4T-tech/4T_L01/README.md

4T_L01

单片机应用技术开发板硬件资料

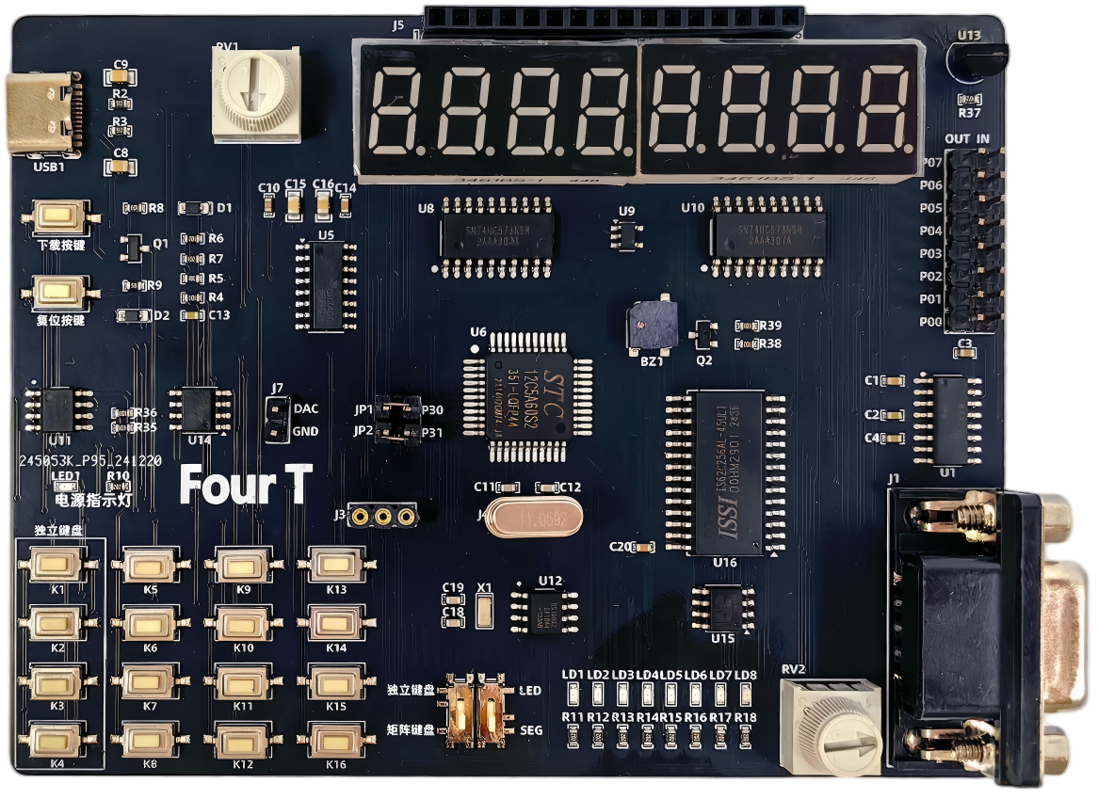
[picture p1: [4]图片/单片机原理及接口技术开发板.png]


## 文件结构
- [1]硬件平台资料：各类文档以及数据手册
  - 单片机原理及接口技术开发板用户手册
  - 数据手册：相关数据手册内容

- [2]综合测试例程：综合测试程序
  - 综合测试程序
  - 测试程序介绍文件
  
- [3]原理图：原理图

- [4]图片：图片资源

- LICENSE：许可证

## 订购渠道

① 官方淘宝：[gxct.taobao.com]()

② 四梯商城：https://www.4t.wiki/mall

③ 官方京东：https://mall.jd.com/index-16359606.html

## 学习资源获取

- QQ交流群：824313199
- 微信公众号：微信搜索“四梯”
- 四梯评测网获取更多竞赛资讯：https://4t.wiki/
  - 交流社区：https://www.4t.wiki/community
  - 学习资源：https://www.4t.wiki/curriculum
- Bilibili平台：参赛选手经验分享、试题解析，B站搜索“四梯科技”
  
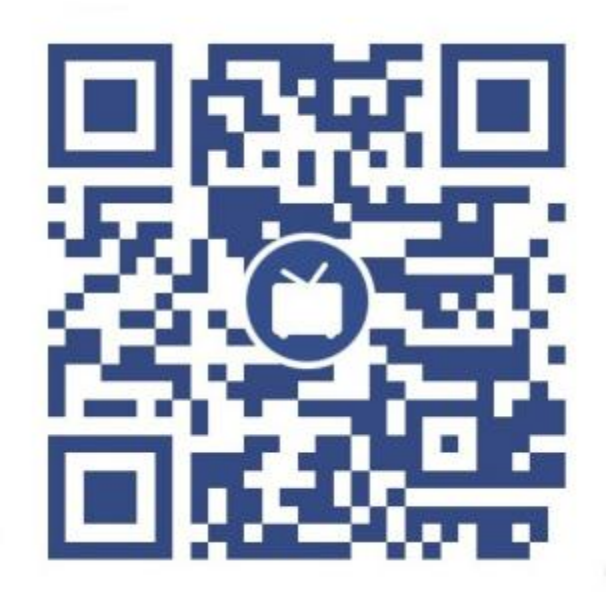
[picture p2: [4]图片/4T_B站.png]
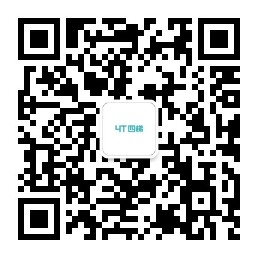
[picture p3: [4]图片/4T_公众号.png]
