4T-tech/4T_L01/(list of files, cad)

Other CAD files:
[2]综合测试例程/综合测试程序/Objects/main.obj
[2]综合测试例程/综合测试程序/Objects/STARTUP.obj
[2]综合测试例程/综合测试程序/Objects/LCD1602.obj
[2]综合测试例程/综合测试程序/Objects/Uart.obj
[2]综合测试例程/综合测试程序/Objects/delay.obj
[2]综合测试例程/综合测试程序/Objects/DS18B20.obj
[2]综合测试例程/综合测试程序/Objects/iic.obj
