4T-tech/4T_L01/[3]原理图/单片机原理及接口技术开发板原理图.pdf

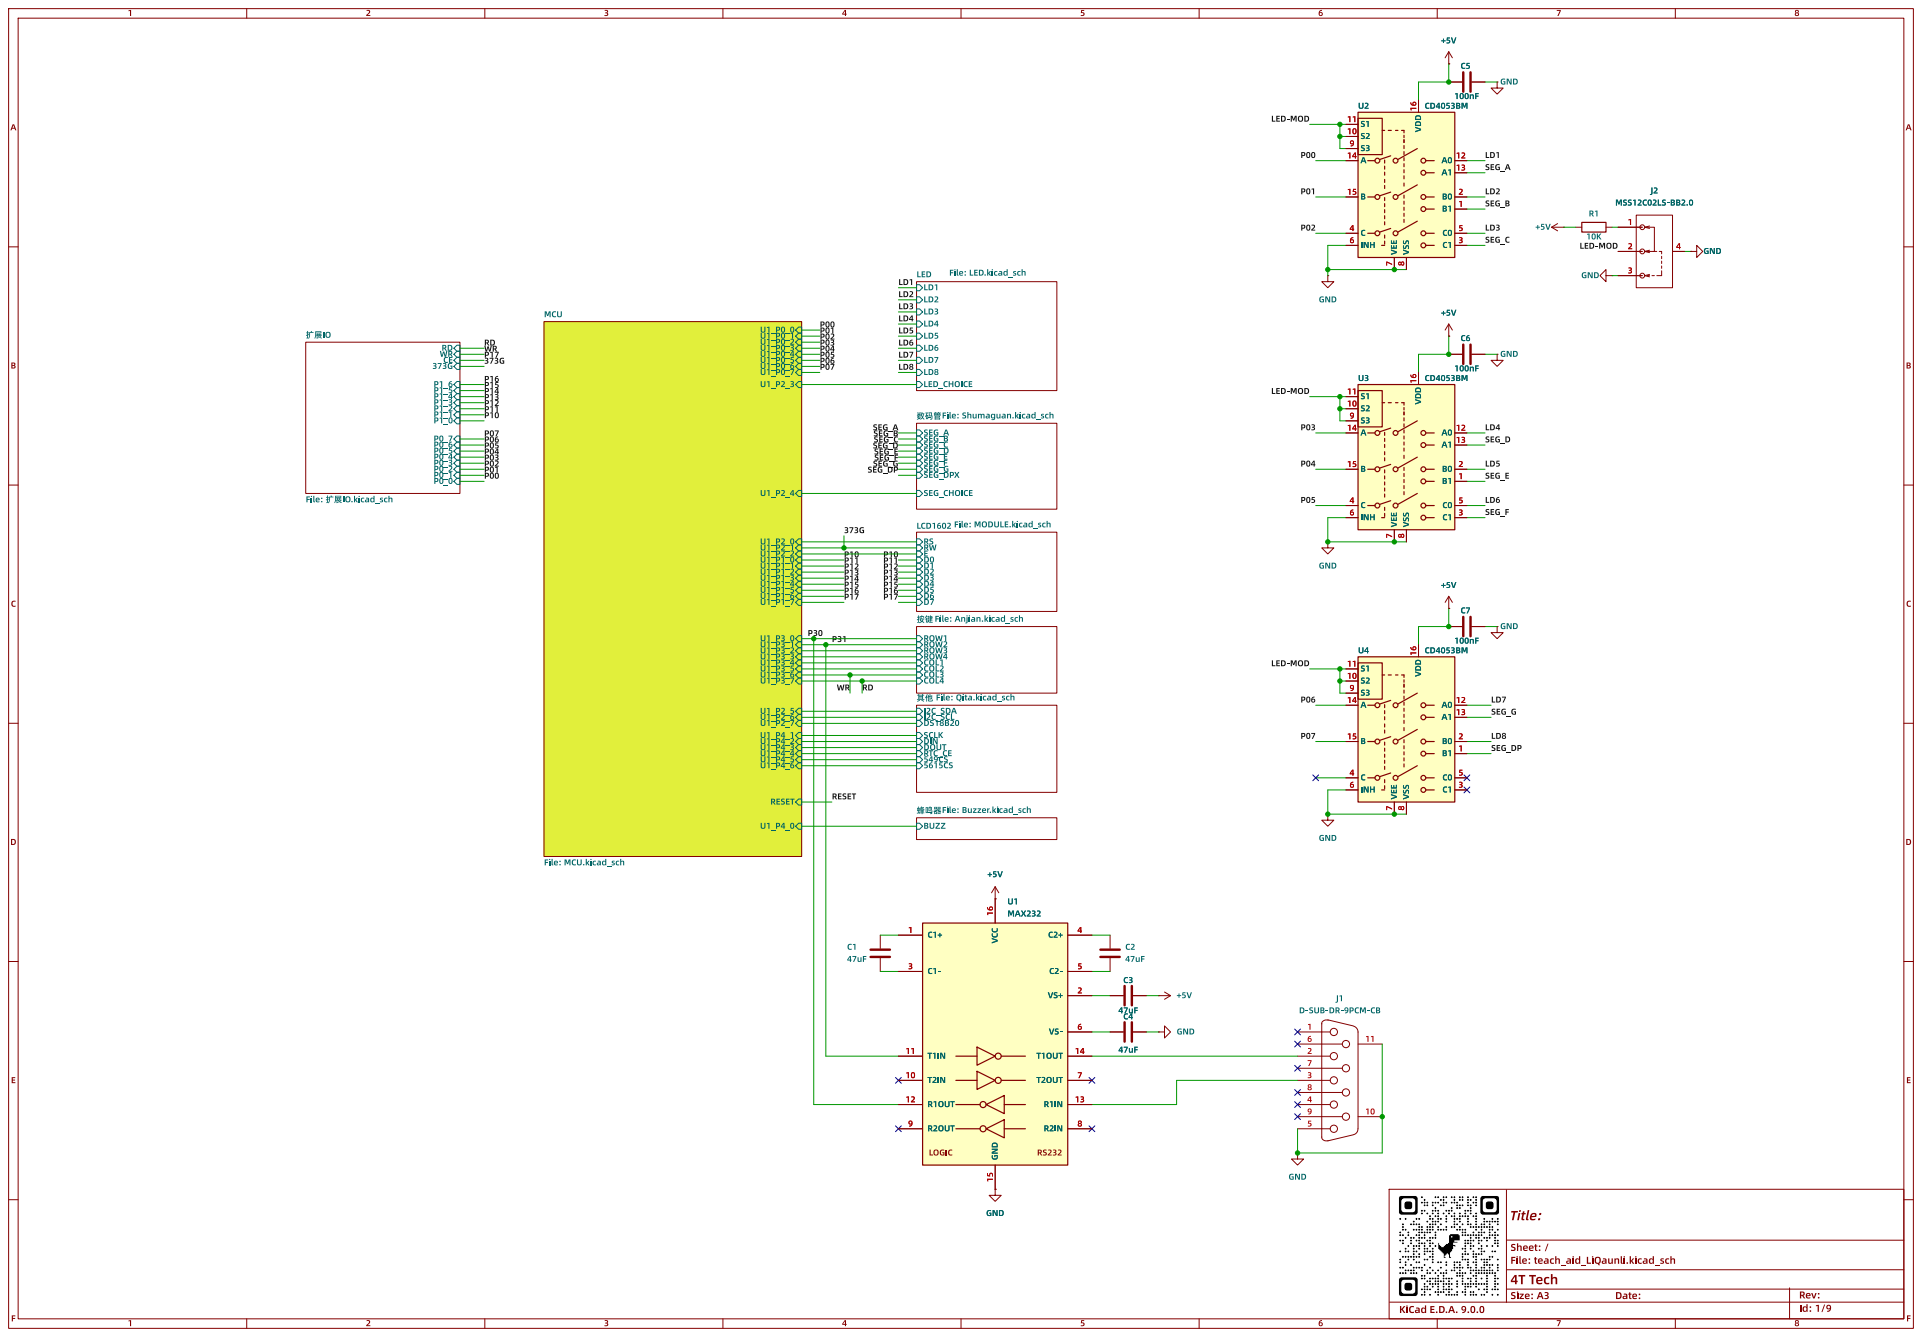
[picture p7: page 1]

Id: 1/9 Title: File: teach_aid_LiQaunli.kicad_sch Sheet: / 4T Tech

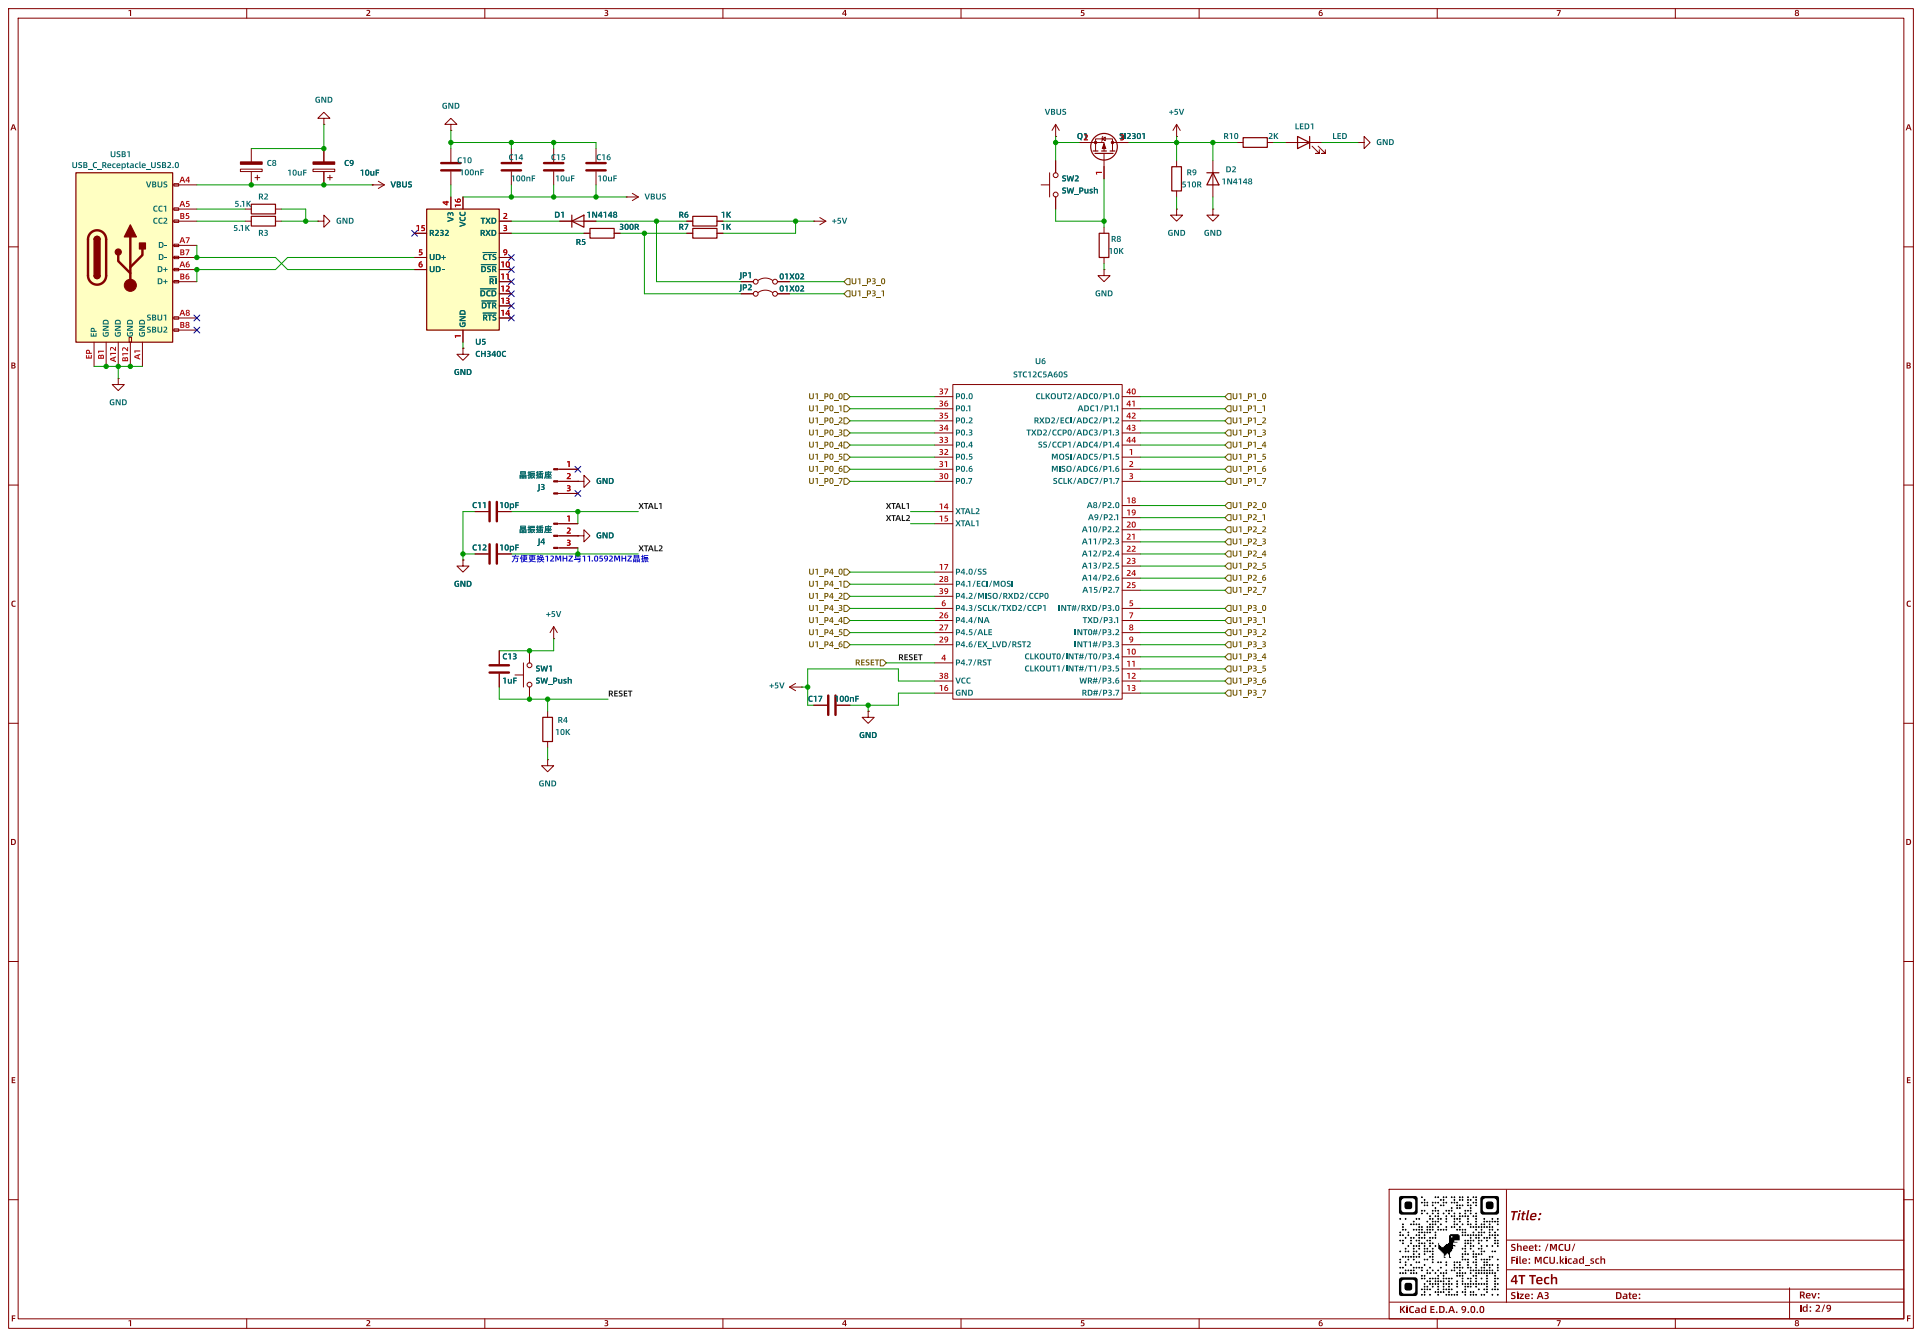
[picture p8: page 2]

3 ~{CTS} 9 ~{DSR} 10 ~{RI} 11 ~{DCD} 12 ~{DTR} 13 ~{RTS} 14 GND

Id: 2/9 Title: File: MCU.kicad_sch Sheet: /MCU/ 4T Tech

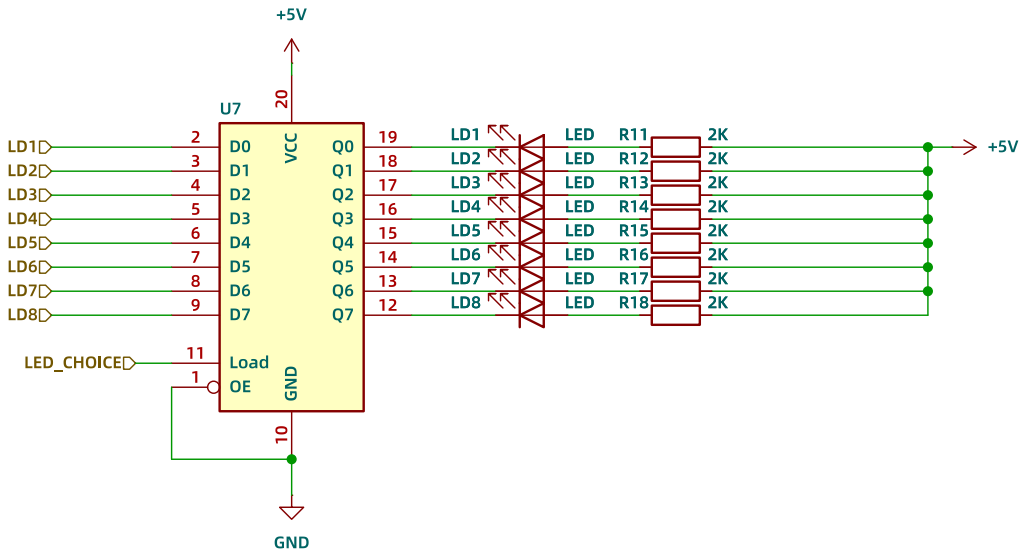
[picture p9: page 3]

Id: 3/9 Title: File: LED.kicad_sch Sheet: /LED/ 4T Tech

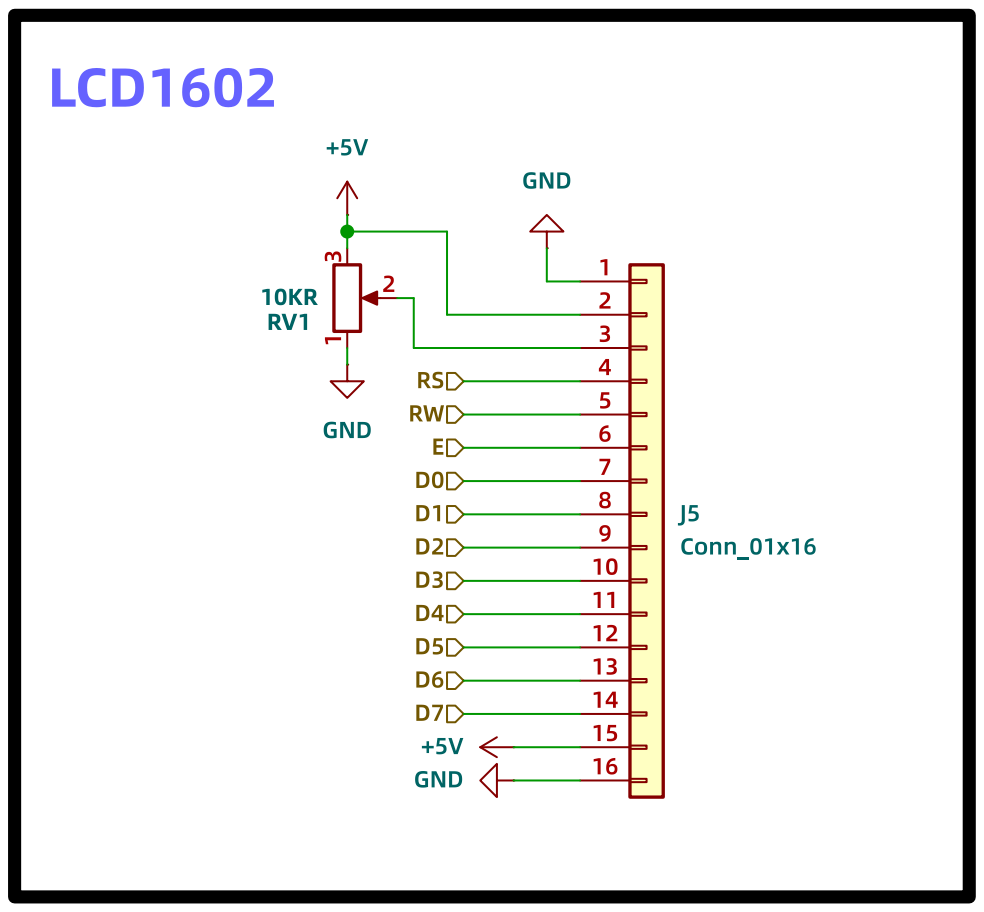
[picture p10: page 4]

Id: 4/9 Title: File: MODULE.kicad_sch Sheet: /LCD1602/ 4T Tech

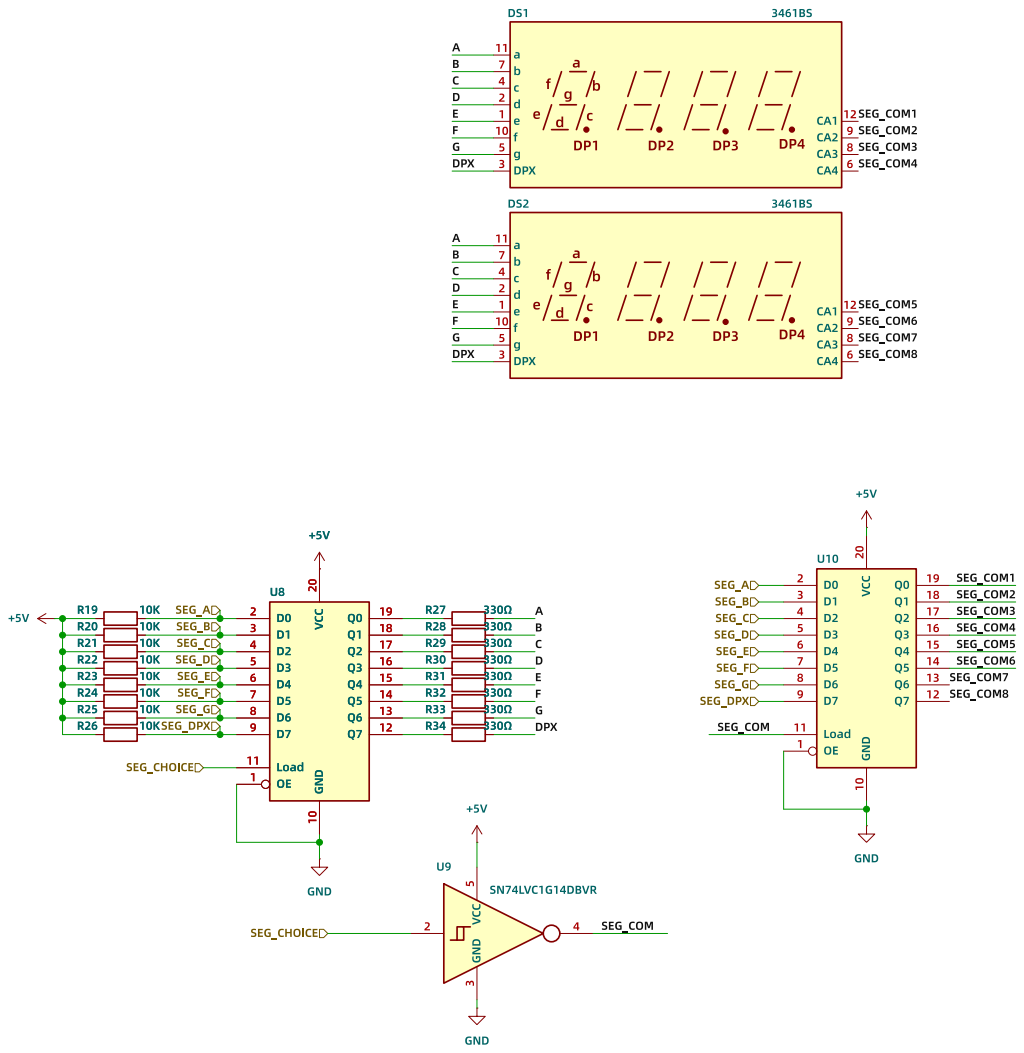
[picture p11: page 5]

Id: 5/9 Title: File: Shumaguan.kicad_sch Sheet: þÿ/epx{¡/

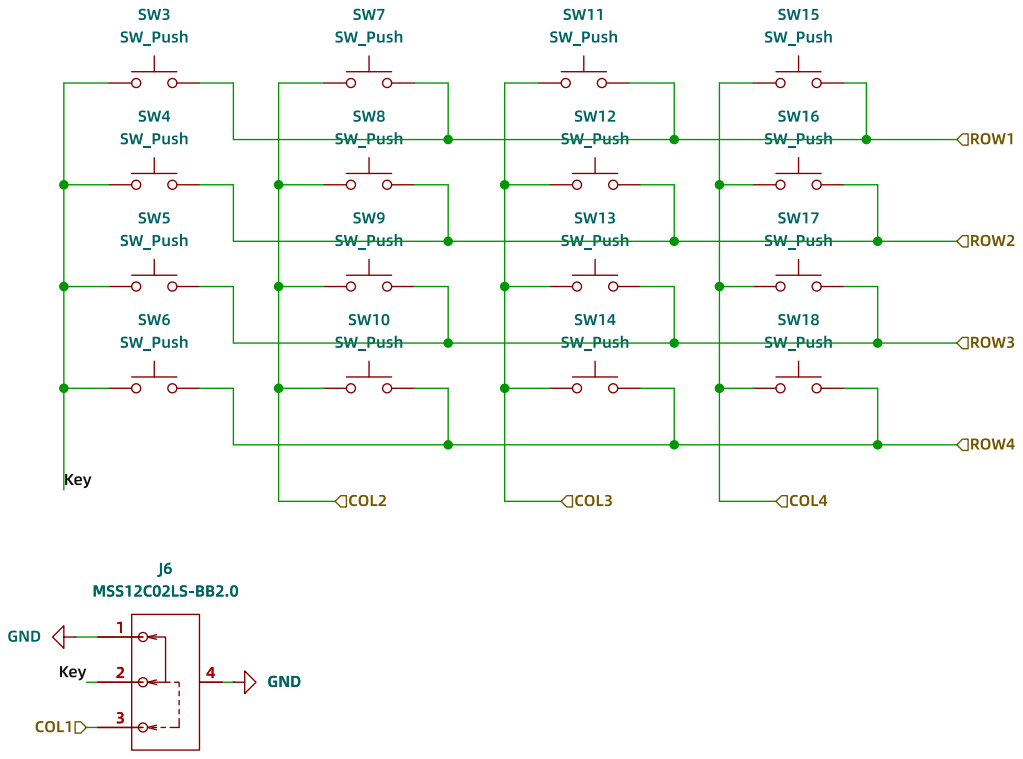
[picture p12: page 6]

Id: 6/9 Title: File: Anjian.kicad_sch Sheet: þÿ/c •./

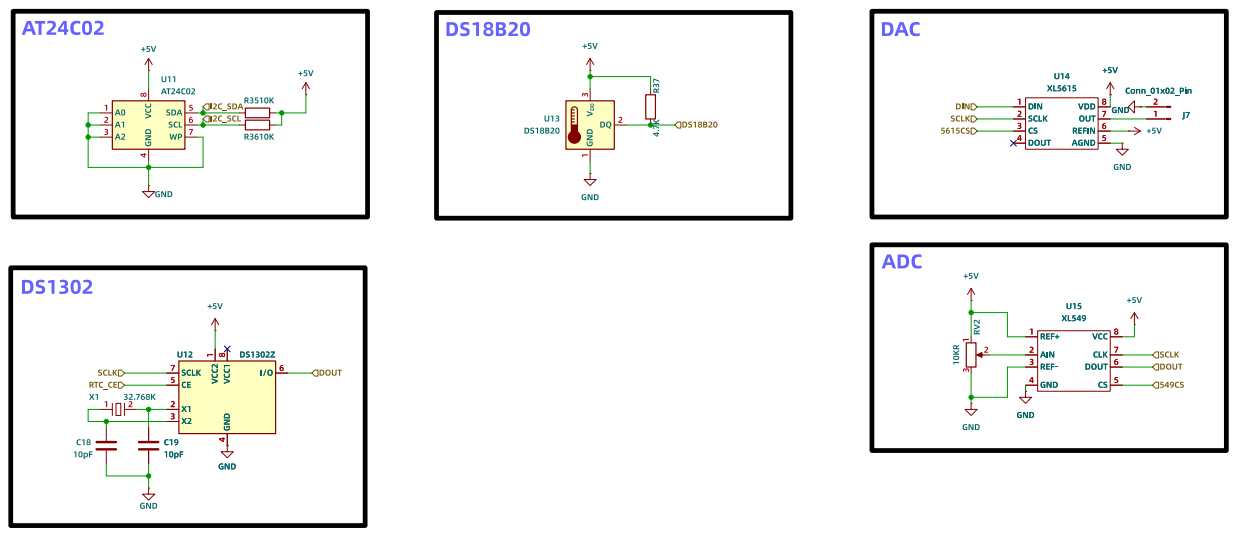
[picture p13: page 7]

1 DQ U13 2 DS18B20 R37 4.7K DOUT DOUT SCLK

Id: 7/9 Title: File: Qita.kicad_sch Sheet: þÿ/QvNÖ/

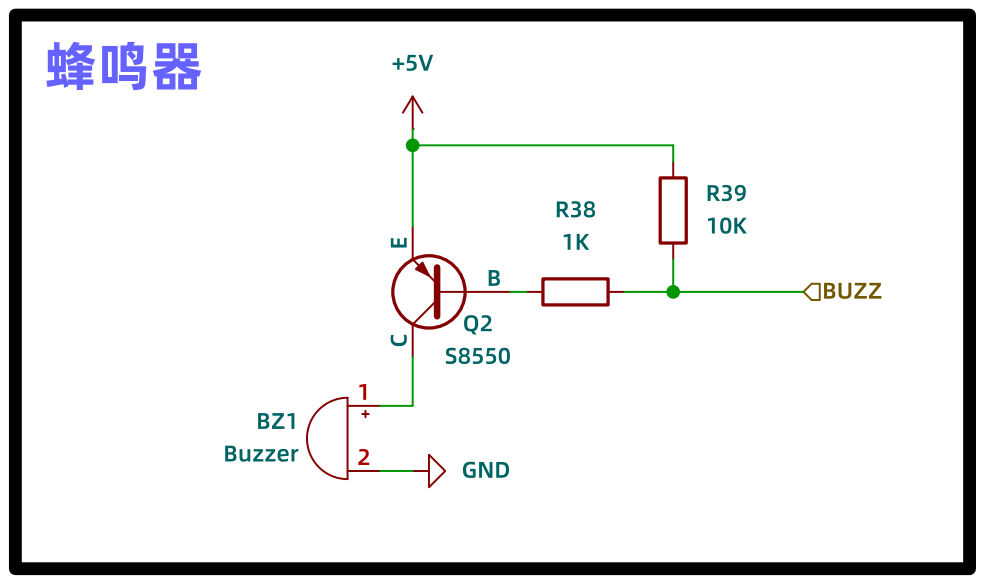
[picture p14: page 8]

Id: 8/9 Title: File: Buzzer.kicad_sch Sheet: þÿ/‡-

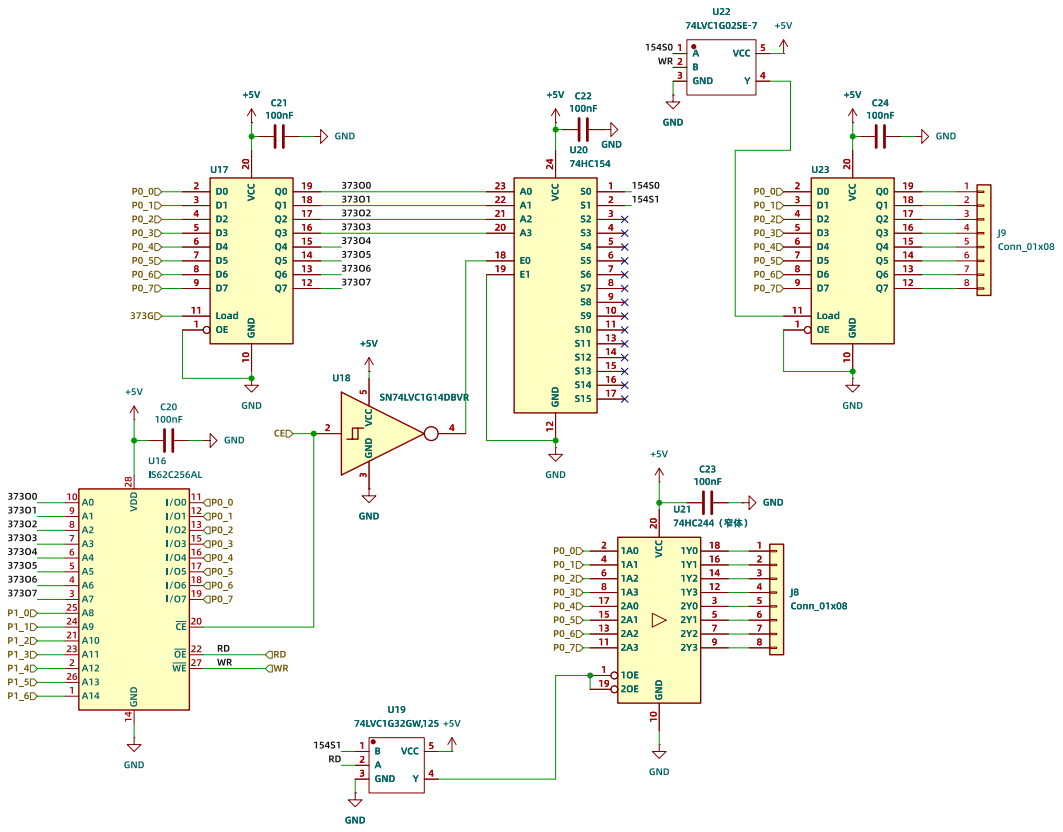
[picture p15: page 9]

þÿ74HC244ÿz„OSÿ GND GND 14 VDD 28 A0

1A2 6 | 14 14
1A3 8 | 12 12

Id: 9/9 Title: File: þÿbi\UIO.kicad_sch Sheet: þÿ/bi\UIO/
