4T-tech/4T_L01/[2]综合测试例程/综合测试程序/ADC.c

//#include "stc12.h"
//#include <intrins.h>

//	
//sbit LED_CHOICE = P2^3;
//sbit SEG_CHOICE = P2^4;

//sbit CS=P4^5;
//sbit CLK=P4^1;
//sbit DOUT=P4^3;
//unsigned char code SegCode[]={0xC0,0xF9,0xA4,0xB0,0x99,0x92,0x82,0xF8,0x80,0x90};//共阴极段码0~9
//unsigned char code BitCode[]={0x08,0x04,0x02,0x01};	//位码:P0口“1”
//																						//有效
//unsigned char DispBuf[4];								//显示缓冲区
//unsigned int Volt;
//void delay_ADC (unsigned int ms)
//{
//    unsigned int i, j;
//    for (i = ms; i > 0; i--)
//    for (j = 113; j > 0; j--);
//}


//unsigned char TLC549_ADC(void)
//{
//	unsigned char i,temp=0;
//	CS=1;
//	CLK =0;
//	CS=0;
//	_nop_();
//	_nop_();
//	for(i=0;i<8;i++)
//	{
//		temp=temp<<1;
//		if (DOUT == 1) temp|=0x01;
//		CLK=1;
//		_nop_();
//		_nop_();
//		CLK =0;
//		_nop_();
//	}
//	_nop_();
//	_nop_();
//	CS =1;
//	return(temp);
//	
//}



//void AD_Buff()				//AD转换值送显示缓冲区(BCD码)
//{
//	DispBuf[3]= Volt /1000;		//千位
//	DispBuf[2]= (Volt/100)%10;	//百位
//	DispBuf[1]=	(Volt /10)%10;	//十位
//	DispBuf[0]= Volt %10;			//个位
//}

//void Display()
//{

//	unsigned char i;
//	SEG_CHOICE=1;
//	P0=0xff;
//	for(i=0;i<4;i++)
//	{
//		if(i==3)
//		{
//			SEG_CHOICE=1;
//			P0=SegCode[DispBuf[i]]&0x7f;
//			SEG_CHOICE=0;
//			P0=BitCode[i];
//			delay_ADC(10);
//		}
//		else
//		{
//			SEG_CHOICE=1;
//			P0=SegCode[DispBuf[i]];
//			SEG_CHOICE=0;
//			P0=BitCode[i];
//			delay_ADC(10);
//		}
//	}
//	
//}

////void main(void)
////{	
////	unsigned char ad;
////	P4SW|=0Xff;
////	P0=0xff;
////	LED_CHOICE=1;
////	LED_CHOICE=0;
////	while(1)
////	{
////		ad=TLC549_ADC();
////		Volt=5*ad/256.0*1000.0;
////		AD_Buff();
////		Display();
////	}
////		
////}
